antelop304g/amilo-bt/线焊接示意.png

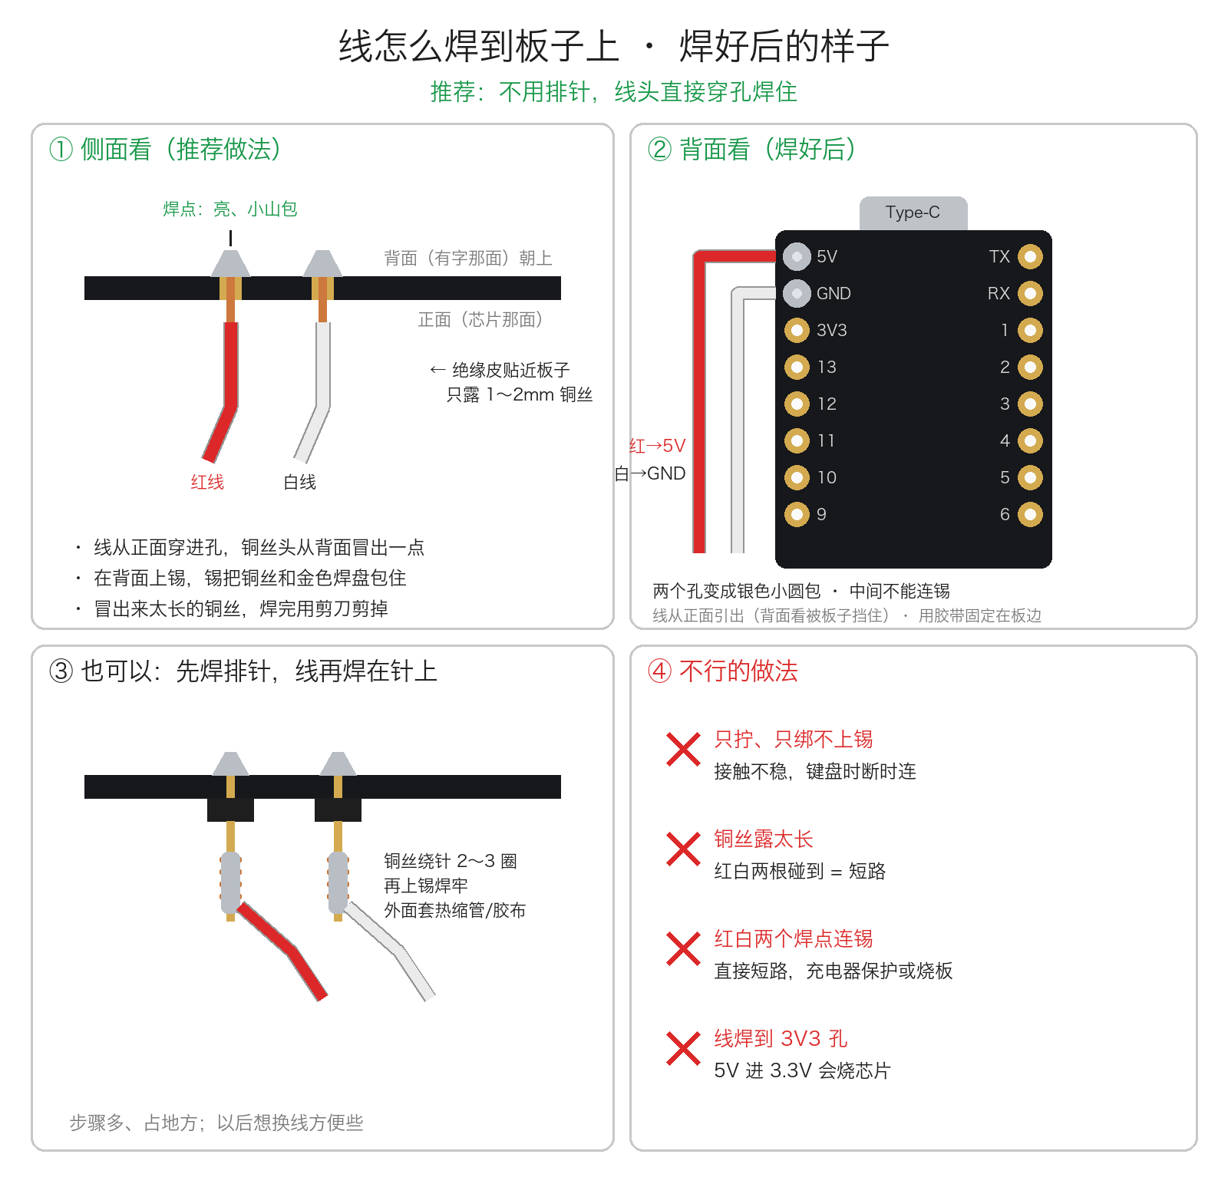
线焊接示意.png
